MohamedAtta22/CNN-convolution-accelerator-/rtl/cnn_accelerator.sv

module cnn_accelerator #(
    parameter  int IMAGE_WIDTH   = 32,
    parameter  int IMAGE_HEIGHT  = 32,
    parameter  int KERNEL_SIZE   = 3,
    parameter  int NUM_KERNELS   = 1,
    localparam int NUM_TAPS      = KERNEL_SIZE * KERNEL_SIZE,
    localparam int KADDR_WIDTH   = (NUM_TAPS <= 1) ? 1 : $clog2(NUM_TAPS),
    localparam int KSEL_WIDTH    = (NUM_KERNELS <= 1) ? 1 : $clog2(NUM_KERNELS)
)(
    input  logic clk,
    input  logic rst_n,
    input  logic start,
    output logic busy,
    output logic done,
    input logic       pixel_valid,
    input logic [7:0] pixel_in,
    input logic                                 kernel_we,
    input logic [KSEL_WIDTH-1:0]                kernel_sel,
    input logic [KADDR_WIDTH-1:0]               kernel_addr,
    input logic signed [7:0]                    kernel_data,
    input logic relu_enable,
    output logic output_valid,
    output logic signed [15:0] pixel_out [0:NUM_KERNELS-1],
    output logic [$clog2(IMAGE_WIDTH)-1:0]  output_col,
    output logic [$clog2(IMAGE_HEIGHT)-1:0] output_row
);

    localparam int OUTPUT_WIDTH = IMAGE_WIDTH - KERNEL_SIZE + 1;
    localparam int OUTPUT_HEIGHT = IMAGE_HEIGHT - KERNEL_SIZE + 1;
    localparam int TOTAL_INPUT_PIXELS = IMAGE_WIDTH * IMAGE_HEIGHT;
    localparam int TOTAL_OUTPUT_PIXELS = OUTPUT_WIDTH * OUTPUT_HEIGHT;
    localparam int COL_WIDTH = (IMAGE_WIDTH <= 1) ? 1 : $clog2(IMAGE_WIDTH);
    localparam int ROW_WIDTH = (IMAGE_HEIGHT <= 1) ? 1 : $clog2(IMAGE_HEIGHT);
    localparam int INPUT_COUNT_WIDTH = (TOTAL_INPUT_PIXELS <= 1) ? 1 : $clog2(TOTAL_INPUT_PIXELS + 1);
    localparam int OUTPUT_COUNT_WIDTH = (TOTAL_OUTPUT_PIXELS <= 1) ? 1 : $clog2(TOTAL_OUTPUT_PIXELS + 1);
    localparam int FIFO_DEPTH      = 64;
    localparam int FIFO_ADDR_WIDTH = 6;
    localparam int PIXEL_BITS      = 16 * NUM_KERNELS;
    localparam int FIFO_DATA_WIDTH = PIXEL_BITS + COL_WIDTH + ROW_WIDTH;
    localparam int FIFO_PREFILL    = (TOTAL_OUTPUT_PIXELS < 60) ? TOTAL_OUTPUT_PIXELS : 60;
    localparam int ADDER_STAGES = (NUM_TAPS <= 1) ? 0 : $clog2(NUM_TAPS);
    localparam int PIPE_DELAY   = ADDER_STAGES + 1;

    typedef enum logic [2:0] {
        S_IDLE,
        S_RUN,
        S_DRAIN,
        S_DONE
    } state_t;

    state_t state;
    logic [INPUT_COUNT_WIDTH-1:0] input_count;
    logic [OUTPUT_COUNT_WIDTH-1:0] output_count;
    logic [7:0] window [0:KERNEL_SIZE-1][0:KERNEL_SIZE-1];
    logic window_valid;
    logic [COL_WIDTH-1:0] window_col;
    logic [ROW_WIDTH-1:0] window_row;

    window_generator #(
        .IMAGE_WIDTH  (IMAGE_WIDTH),
        .IMAGE_HEIGHT (IMAGE_HEIGHT),
        .KERNEL_SIZE  (KERNEL_SIZE)
    ) u_window_generator (
        .clk(clk),
        .rst_n(rst_n),
        .pixel_valid(
            pixel_valid && (state == S_RUN)
        ),
        .pixel_in(pixel_in),
        .window(window),
        .window_valid(window_valid),
        .window_col(window_col),
        .window_row(window_row)
    );

    logic signed [7:0] kernel [0:NUM_KERNELS-1][0:NUM_TAPS-1];
    kernel_memory #(
        .KERNEL_SIZE (KERNEL_SIZE),
        .NUM_KERNELS (NUM_KERNELS)
    ) u_kernel_memory (
        .clk(clk),
        .rst_n(rst_n),
        .kernel_we(
            kernel_we && (state == S_IDLE)
        ),
        .kernel_sel(kernel_sel),
        .kernel_addr(kernel_addr),
        .kernel_data(kernel_data),
        .kernel(kernel)
    );

    logic [7:0] window_flat [0:NUM_TAPS-1];
    always_comb begin
        for (int r = 0; r < KERNEL_SIZE; r++)
            for (int c = 0; c < KERNEL_SIZE; c++)
                window_flat[r*KERNEL_SIZE + c] = window[r][c];
    end

    logic signed [31:0] accumulator [0:NUM_KERNELS-1];
    logic                accumulator_valid [0:NUM_KERNELS-1];
    logic                post_process_valid [0:NUM_KERNELS-1];
    logic signed [15:0]  post_process_data [0:NUM_KERNELS-1];

    genvar k;
    generate
        for (k = 0; k < NUM_KERNELS; k++) begin : KCH
            logic signed [7:0]  kernel_bank  [0:NUM_TAPS-1];
            logic signed [15:0] product_bank [0:NUM_TAPS-1];

            always_comb begin
                for (int t = 0; t < NUM_TAPS; t++)
                    kernel_bank[t] = kernel[k][t];
            end

            mac_array #(
                .NUM_TAPS (NUM_TAPS)
            ) u_mac_array (
                .pixel(window_flat),
                .kernel(kernel_bank),
                .product(product_bank)
            );

            adder_tree #(
                .NUM_INPUTS (NUM_TAPS),
                .IN_WIDTH   (16),
                .OUT_WIDTH  (32)
            ) u_adder_tree (
                .clk(clk),
                .rst_n(rst_n),
                .valid_in(window_valid),
                .product(product_bank),
                .valid_out(accumulator_valid[k]),
                .sum_out(accumulator[k])
            );

            post_process u_post_process (
                .clk(clk),
                .rst_n(rst_n),
                .valid_in(accumulator_valid[k]),
                .accumulator(accumulator[k]),
                .relu_enable(relu_enable),
                .valid_out(post_process_valid[k]),
                .output_data(post_process_data[k])
            );
        end
    endgenerate

    logic [COL_WIDTH-1:0] col_pipe [0:PIPE_DELAY-1];
    logic [ROW_WIDTH-1:0] row_pipe [0:PIPE_DELAY-1];
    always_ff @(posedge clk or negedge rst_n) begin
        if (!rst_n) begin
            for (int i = 0; i < PIPE_DELAY; i++) begin
                col_pipe[i] <= '0;
                row_pipe[i] <= '0;
            end
        end
        else begin
            if (window_valid) begin
                col_pipe[0] <= window_col;
                row_pipe[0] <= window_row;
            end

            for (int i = 1; i < PIPE_DELAY; i++) begin
                col_pipe[i] <= col_pipe[i-1];
                row_pipe[i] <= row_pipe[i-1];
            end
        end
    end
    logic [COL_WIDTH-1:0] pipe_col;
    logic [ROW_WIDTH-1:0] pipe_row;

    assign pipe_col = col_pipe[PIPE_DELAY-1];
    assign pipe_row = row_pipe[PIPE_DELAY-1];

    logic [FIFO_DATA_WIDTH-1:0] fifo_write_data;
    logic [FIFO_DATA_WIDTH-1:0] fifo_read_data;
    logic [FIFO_ADDR_WIDTH:0]   fifo_level;
    logic                       fifo_empty;
    logic                       fifo_full;
    logic                       fifo_read_en;
    logic                       fifo_started;

    logic [PIXEL_BITS-1:0] fifo_pixel_bits;
    always_comb begin
        for (int kk = 0; kk < NUM_KERNELS; kk++)
            fifo_pixel_bits[kk*16 +: 16] = post_process_data[kk];
    end

    assign fifo_write_data = {
        pipe_row,
        pipe_col,
        fifo_pixel_bits
    };

    output_fifo #(
        .DATA_WIDTH (FIFO_DATA_WIDTH),
        .DEPTH      (FIFO_DEPTH),
        .ADDR_WIDTH (FIFO_ADDR_WIDTH)
    ) u_output_fifo (
        .clk(clk),
        .rst_n(rst_n),
        .write_en(post_process_valid[0]),
        .write_data(fifo_write_data),
        .read_en(fifo_read_en),
        .read_data(fifo_read_data),
        .level(fifo_level),
        .empty(fifo_empty),
        .full(fifo_full)
    );

    always_ff @(posedge clk or negedge rst_n) begin
        if (!rst_n) begin
            fifo_started <= 1'b0;
        end
        else begin
            if (state == S_IDLE)
                fifo_started <= 1'b0;
            else if (!fifo_started && (fifo_level >= FIFO_PREFILL[FIFO_ADDR_WIDTH:0]))
                fifo_started <= 1'b1;
        end
    end

    assign fifo_read_en = fifo_started && !fifo_empty;

    logic                       output_valid_reg;
    logic signed [15:0]         pixel_out_reg [0:NUM_KERNELS-1];
    logic [COL_WIDTH-1:0]       output_col_reg;
    logic [ROW_WIDTH-1:0]       output_row_reg;

    always_ff @(posedge clk or negedge rst_n) begin
        if (!rst_n) begin
            output_valid_reg <= 1'b0;
            output_col_reg   <= '0;
            output_row_reg   <= '0;
            for (int kk = 0; kk < NUM_KERNELS; kk++)
                pixel_out_reg[kk] <= '0;
        end
        else begin
            output_valid_reg <= fifo_read_en;
            if (fifo_read_en) begin
                for (int kk = 0; kk < NUM_KERNELS; kk++)
                    pixel_out_reg[kk] <= $signed(fifo_read_data[kk*16 +: 16]);
                output_col_reg <= fifo_read_data[PIXEL_BITS +: COL_WIDTH];
                output_row_reg <= fifo_read_data[(PIXEL_BITS + COL_WIDTH) +: ROW_WIDTH];
            end
        end
    end

    assign output_valid = output_valid_reg;
    assign pixel_out    = pixel_out_reg;
    assign output_col   = output_col_reg;
    assign output_row   = output_row_reg;

    always_ff @(posedge clk or negedge rst_n) begin
        if (!rst_n) begin
            input_count <= '0;
        end
        else begin
            case (state)
                S_IDLE: begin
                    input_count <= '0;
                end
                S_RUN: begin
                    if (pixel_valid && (input_count < TOTAL_INPUT_PIXELS)) begin
                        input_count <= input_count + 1'b1;
                    end
                end
                default: begin
                end
            endcase
        end
    end
    always_ff @(posedge clk or negedge rst_n) begin
        if (!rst_n) begin
            output_count <= '0;
        end
        else begin
            case (state)
                S_IDLE: begin
                    output_count <= '0;
                end
                default: begin
                    if (output_valid && (output_count < TOTAL_OUTPUT_PIXELS)) begin
                        output_count <= output_count + 1'b1;
                    end
                end
            endcase
        end
    end

    always_ff @(posedge clk or negedge rst_n) begin
        if (!rst_n) begin
            state <= S_IDLE;
        end
        else begin
            case (state)
                S_IDLE: begin
                    if (start) begin
                        state <= S_RUN;
                    end
                end
                S_RUN: begin
                    if (input_count == TOTAL_INPUT_PIXELS) begin
                        state <= S_DRAIN;
                    end
                end
                S_DRAIN: begin
                    if (output_valid && (output_count == TOTAL_OUTPUT_PIXELS - 1)) begin
                        state <= S_DONE;
                    end
                end
                S_DONE: begin
                    state <= S_IDLE;
                end
                default: begin
                    state <= S_IDLE;
                end
            endcase
        end
    end
    always_comb begin
        busy = 1'b0;
        done = 1'b0;
        case (state)
            S_IDLE: begin
                busy = 1'b0;
                done = 1'b0;
            end
            S_RUN: begin
                busy = 1'b1;
                done = 1'b0;
            end
            S_DRAIN: begin
                busy = 1'b1;
                done = 1'b0;
            end
            S_DONE: begin
                busy = 1'b0;
                done = 1'b1;
            end
            default: begin
                busy = 1'b0;
                done = 1'b0;
            end
        endcase
    end

endmodule
